CodeByAtharvSingh/Mavrik-Pocket/BOM.csv

Category | Item | Exact listing | Qty | Unit price (USD, as listed) | Line total (USD) | Line total with GST (USD) | Store | Link | Status | Notes
Electronics | Brain: ESP32-S3 N16R8 dev board | ESP32E-N16R8 Dual C-Type DOIT USB Development Board WiFi + Bluetooth Module | 1 | 7.27 | 7.27 | 8.58 | Quartz Components | https://quartzcomponents.com/products/esp32-s3-wroom-n16r8-dual-c-type-usb-development-board-wifi-bluetooth-module | Buy | 16 MB flash, 8 MB PSRAM. Check the chip cover says ESP32-S3-WROOM-1 N16R8
Electronics | Screen: 2.8 inch 240x320 SPI | 2.8 Inch SPI Touch Screen Display Module - TFT Display 240x320 | 1 | 7.97 | 7.97 | 9.41 | Quartz Components | https://quartzcomponents.com/products/2-8-inch-spi-touch-screen-module-tft-display-240-320 | Buy | ILI9341 driver; SD slot on the back holds the music and ideas
Electronics | Battery: 3.7 V 1200 mAh LiPo | 3.7V 1200mAH Li-Po Rechargeable Battery (KP 523450) | 1 | 2.50 | 2.50 | 2.94 | Quartz Components | https://quartzcomponents.com/products/3-7v-1200mah-li-po-rechargeable-battery | Buy | 5.2 x 34 x 50 mm. Check it is not puffed up when it arrives
Electronics | Charging + 5 V power | USB Type-C 5V Step-Up Booster Lithium Battery Charging and Protection Module | 1 | 0.29 | 0.29 | 0.34 | Quartz Components | https://quartzcomponents.com/products/usb-type-c-5v-step-up-booster-lithium-battery-charging-and-protection-module-for-power-bank | Buy | Charges the battery over USB-C and powers the board
Electronics | Microphone: INMP441 I2S | INMP441 MEMS Microphone Module I2S | 1 | 1.37 | 1.37 | 1.37 | Robo Bazar | https://robobazar.in/product/inmp441-mems-microphone-module-i2s/ | Buy | Sold out at Quartz: https://quartzcomponents.com/products/inmp441-mems-high-precision-omnidirectional-microphone-module-i2s
Electronics | Speaker amp: MAX98357A I2S | MAX98357 I2S Amplifier Audio | 1 | 0.90 | 0.90 | 0.90 | Robo Bazar | https://robobazar.in/product/max98357-i2s-amplifier-audio | Buy | Sold out at Quartz: https://quartzcomponents.com/products/max98357-3w-amplifier
Electronics | Speaker: 8 ohm 0.5 W | 0.5W 8 Ohm Speaker | 1 | 0.38 | 0.38 | 0.45 | Quartz Components | https://quartzcomponents.com/products/speaker-0-5w-8-ohm | Buy
Electronics | Scroll wheel: rotary encoder | HW-040 Rotary Encoder Module with Knob | 1 | 0.95 | 0.95 | 0.95 | Probots | https://probots.co.in/hw-040-rotary-encoder-module-with-knob-360-degree.html | Buy | Sold out at Quartz: https://quartzcomponents.com/products/rotary-encoder-module-ky-040. Trim the shaft to 5 mm above the thread for the printed knob
Electronics | Buttons: Action and Back | Tactile Momentary Push Button Switch 12x12x8mm 4-Pin | 2 | 0.04 | 0.09 | 0.10 | Quartz Components | https://quartzcomponents.com/products/tactile-momentary-push-button-switch-12-12-8mm-4-pin-black | Buy | Pressed by the printed side plungers
Electronics | Haptics: coin vibration motor | Micro Coin Vibration Motor (Page Motor) - 10mm Good Quality | 1 | 0.34 | 0.34 | 0.40 | Quartz Components | https://quartzcomponents.com/products/micro-coin-vibration-motor-page-motor-8mm | Buy | 10 x 3 mm, 3 V
Electronics | Motor driver transistor | BC547 NPN Transistor | 1 | 0.03 | 0.03 | 0.04 | Quartz Components | https://quartzcomponents.com/products/bc547-npn-amplifier-transistor | Buy
Electronics | Motor protection diode | 1N4007 General Purpose Rectifier Diode 1A | 1 | 0.02 | 0.02 | 0.02 | Quartz Components | https://quartzcomponents.com/products/1n4007-diode | Buy | Across the motor, stripe to +
Electronics | Transistor base resistor | 1K ohm 1/4 Watt Resistor 5% (Pack of 10) | 1 | 0.07 | 0.07 | 0.09 | Quartz Components | https://quartzcomponents.com/products/1k-ohm-1-4-watt-resistor | Buy | Smallest pack sold
Electronics | Storage: microSD card | SanDisk Ultra Micro SD 32GB Class 10 | 1 | 0.00 | 0.00 | 0.00 | Quartz Components | https://quartzcomponents.com/products/32gb-ultra-microsd-memory-card-red-grey | Already own | Use a card you already have (any 4-32 GB works). Quartz price if you need one: $15.93
Assembly | Perfboard for the final wiring | 50 x 70 mm Double Side Prototype PCB | 1 | 0.34 | 0.34 | 0.40 | Quartz Components | https://quartzcomponents.com/products/wifi-esp8266-double-side-prototype-pcb-breadboard-50x70mm | Buy | Holds the motor driver and button wiring. No custom PCB in this prototype
Assembly | Header pins | 40 Pin Straight Male Header Pins - Berg Strips | 1 | 0.07 | 0.07 | 0.09 | Quartz Components | https://quartzcomponents.com/products/40-pin-break-away-headers-straight-male-headers | Buy
Assembly | Jumper wires | Female to Female Jumper Wires 10cm (Set of 40) | 1 | 0.40 | 0.40 | 0.48 | Quartz Components | https://quartzcomponents.com/products/female-to-female-connecting-wires-jumper-wires-10cm-set-of-40 | Buy | Short wires fit inside the case
Assembly | Breadboard for first tests | MB102 Breadboard 830 Points with Jumper Wires (Set of 80) | 1 | 1.96 | 1.96 | 2.31 | Quartz Components | https://quartzcomponents.com/products/mb102-colored-breadboard-830-points-with-jumper-wires-male-to-male-and-male-to-female-set-of-80 | Buy | Test everything here before soldering
Enclosure | Front shell, back cover, wheel knob, 2 button plungers | SLA resin print (black resin) from STEP Files/Prototype case | 1 | 21.26 | 21.26 | 21.26 | JLC3DP | https://jlc3dp.com/ | Buy | Resin gives the smooth, sharp-edged finish closest to an iPhone. About 60 cm3 of resin. Estimate incl. shipping to India: upload the STEP files for the exact price. Indian option: Zbotic SLA (15-20 days) https://zbotic.in/3d-printing-service/sla/
Tools | Soldering iron | Soldering Iron/Rod (25W) Noel | 1 | 1.21 | 1.21 | 1.44 | Quartz Components | https://quartzcomponents.com/products/soldering-iron-25w | Buy | A 25 W iron is enough for every joint here
Tools | Solder wire | Small Package Solder Wire 5 g | 2 | 0.24 | 0.49 | 0.57 | Quartz Components | https://quartzcomponents.com/products/akt-solder-wire-5gm | Buy | About 100 joints
Tools | Flux | Soldering and Desoldering Flux Paste 10 g | 1 | 0.23 | 0.23 | 0.28 | Quartz Components | https://quartzcomponents.com/collections/soldering-accessories/products/soldering-and-desoldering-flux-paste-white | Buy
Total | Everything to buy |  |  |  |  | 52.42 |  |  |  | Quartz prices + 18% GST; Robo Bazar and Probots prices already include GST; the enclosure print is an estimate. Shipping on the small orders not included. Converted at 1 USD = 94.07 INR (12 Nov 2026)
