CodeByAtharvSingh/Mavrik-Pocket/STEP Files/Concept 8mm/00_full_assembly.step

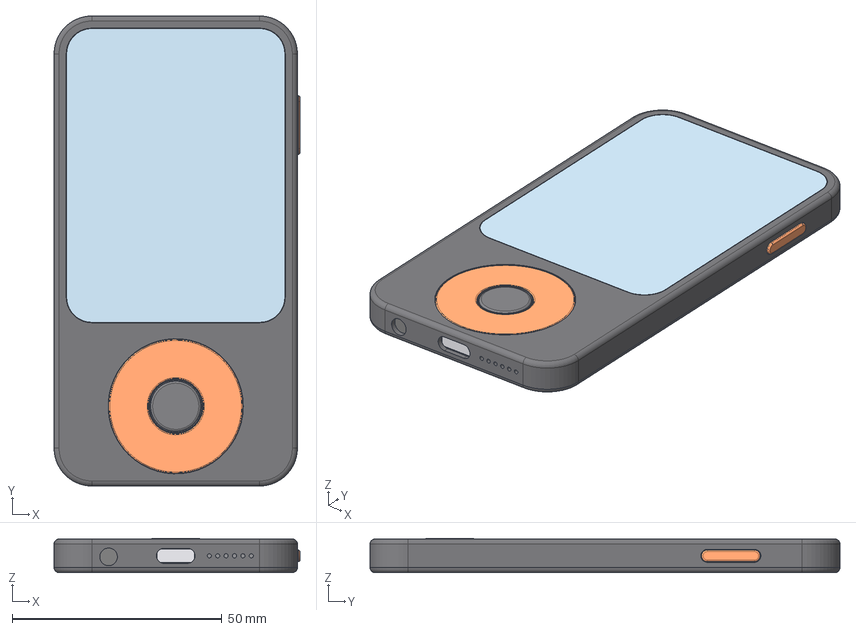
[picture p9: CAD file, 2026-11-12]
STEP Files/Concept 8mm/00_full_assembly.step
58.6 x 112.0 x 8.15 mm
front_shell
back_cover
cover_glass
touch_wheel_ring
centre_button
action_button
magnet_ring
lanyard_pin
ref_display_panel
ref_battery_3x40x50
ref_main_pcb
ref_select_dome
ref_touch_wheel_flex
ref_usb_c_socket
ref_headphone_jack
ref_speaker_box
ref_mic
ref_haptic_motor
