CodeByAtharvSingh/Mavrik-Pocket/STEP Files/Concept 8mm/ref_main_pcb.step

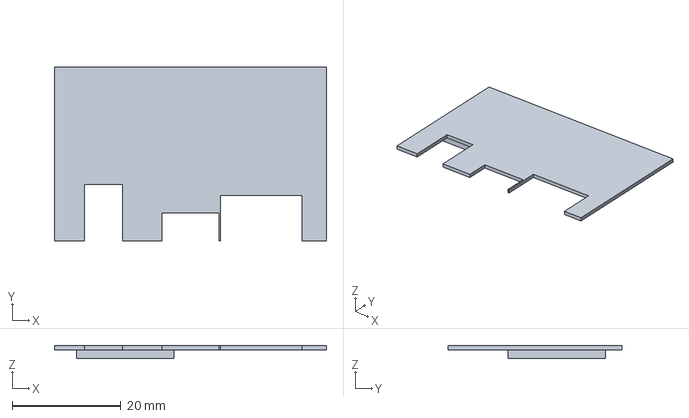
[picture p10: CAD file, 2026-11-12]
STEP Files/Concept 8mm/ref_main_pcb.step
50.0 x 32.0 x 2.40 mm
