CodeByAtharvSingh/Mavrik-Pocket/STEP Files/Prototype case/00_full_assembly.step

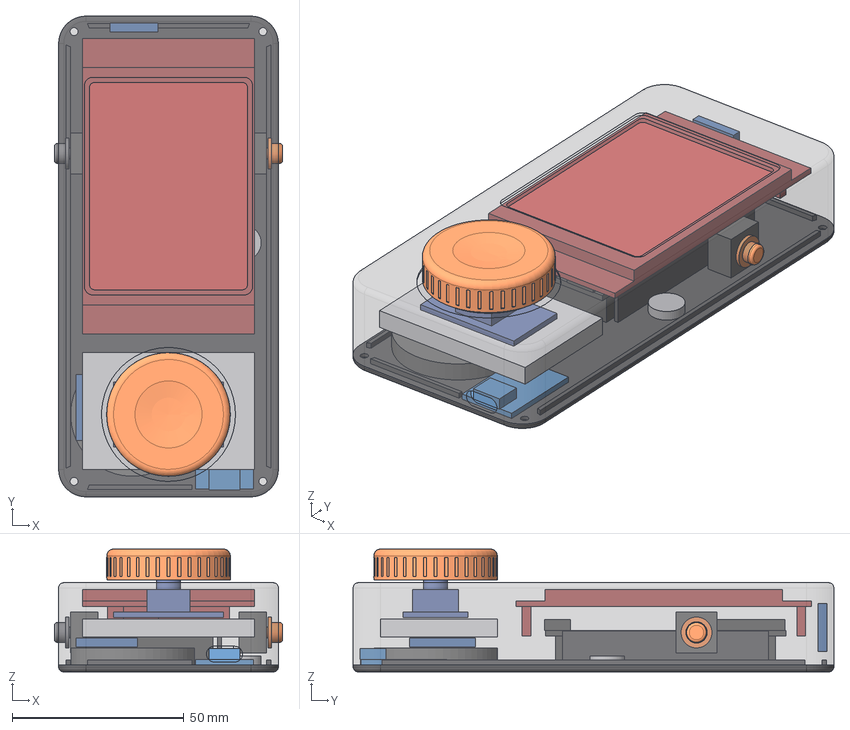
[picture p11: CAD file, 2026-11-12]
STEP Files/Prototype case/00_full_assembly.step
66.4 x 140.0 x 35.8 mm
front_shell
back_cover
wheel_knob
action_plunger
back_plunger
ref_screen_module
ref_esp32_s3_devboard
ref_battery_523450
ref_encoder_ky040
ref_speaker
ref_charger_module
ref_tactile_switches
ref_mic_inmp441
ref_amp_max98357
ref_vibration_motor
