CodeByAtharvSingh/Mavrik-Pocket/STEP Files/Concept 8mm/lanyard_pin.step

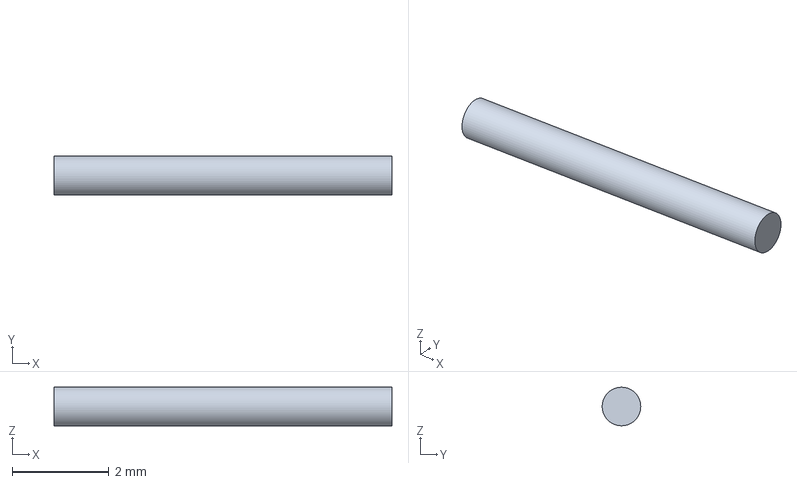
[picture p12: CAD file, 2026-11-12]
STEP Files/Concept 8mm/lanyard_pin.step
7.00 x 0.799 x 0.8 mm
