CodeByAtharvSingh/Mavrik-Pocket/STEP Files/Prototype case/ref_battery_523450.step

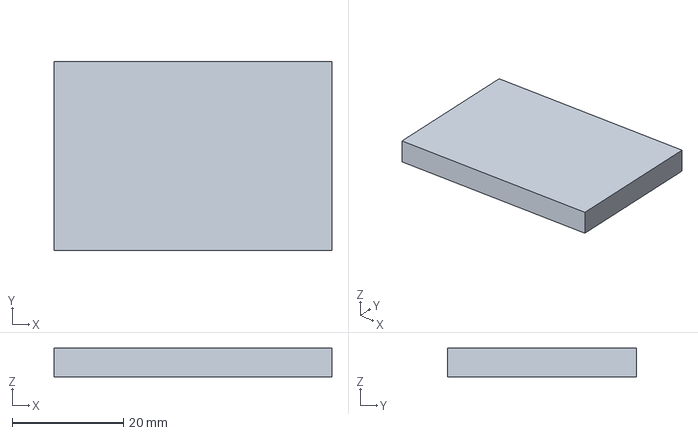
[picture p13: CAD file, 2026-11-12]
STEP Files/Prototype case/ref_battery_523450.step
50.0 x 34.0 x 5.20 mm
