CodeByAtharvSingh/Mavrik-Pocket/STEP Files/Concept 8mm/ref_mic.step

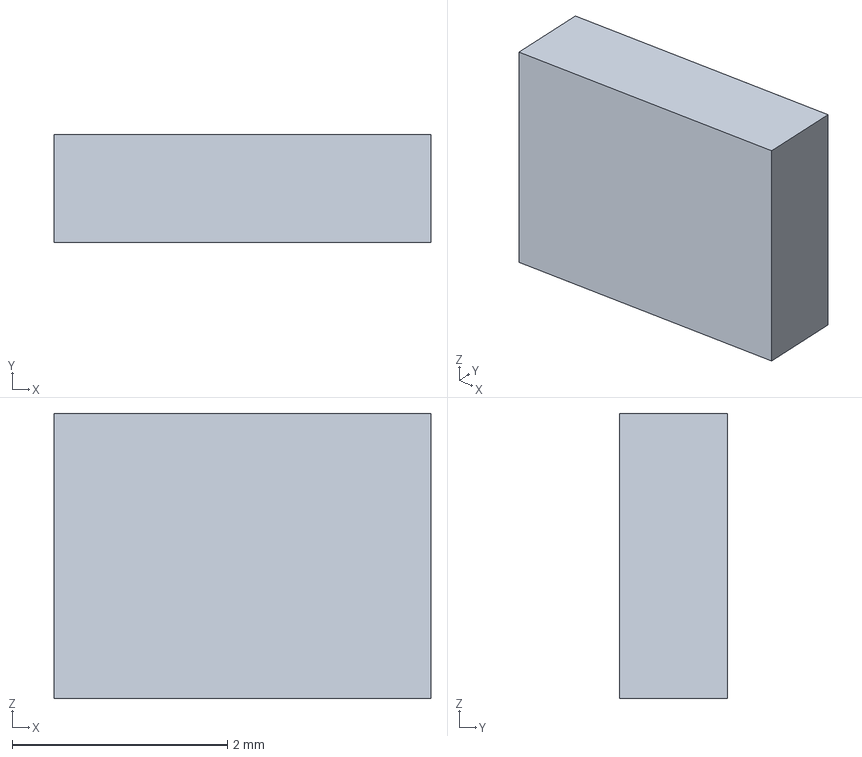
[picture p14: CAD file, 2026-11-12]
STEP Files/Concept 8mm/ref_mic.step
3.50 x 1.00 x 2.65 mm
