CodeByAtharvSingh/Mavrik-Pocket/STEP Files/Prototype case/ref_esp32_s3_devboard.step

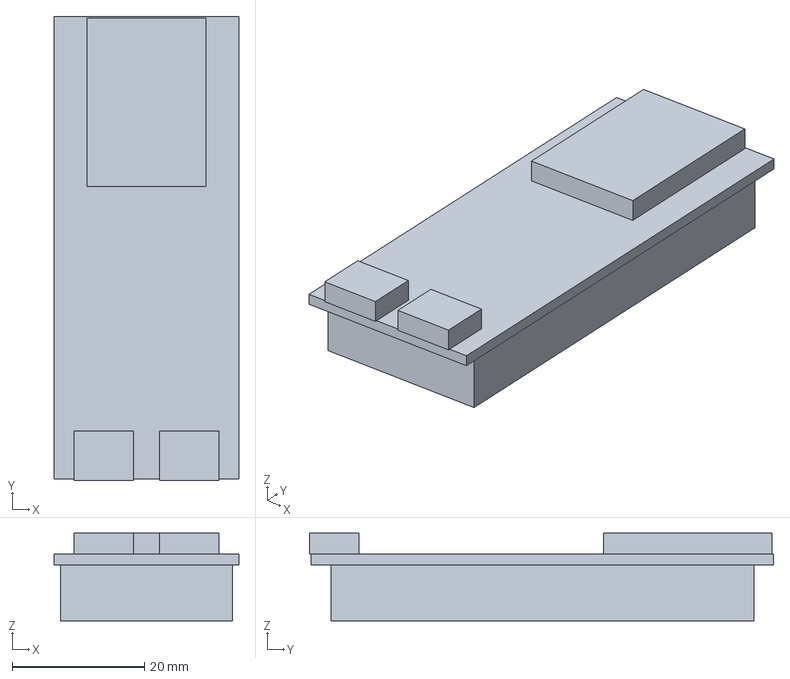
[picture p15: CAD file, 2026-11-12]
STEP Files/Prototype case/ref_esp32_s3_devboard.step
28.0 x 70.2 x 13.3 mm
