CodeByAtharvSingh/Mavrik-Pocket/STEP Files/Prototype case/back_cover.step

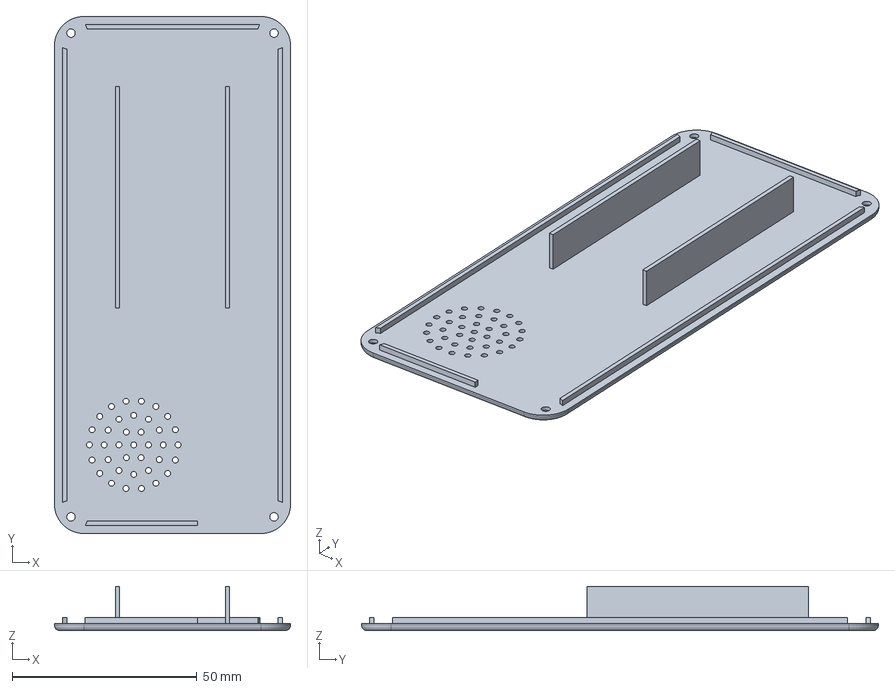
[picture p16: CAD file, 2026-11-12]
STEP Files/Prototype case/back_cover.step
64.0 x 140.0 x 12.0 mm
