CodeByAtharvSingh/Mavrik-Pocket/STEP Files/Concept 8mm/front_shell.step

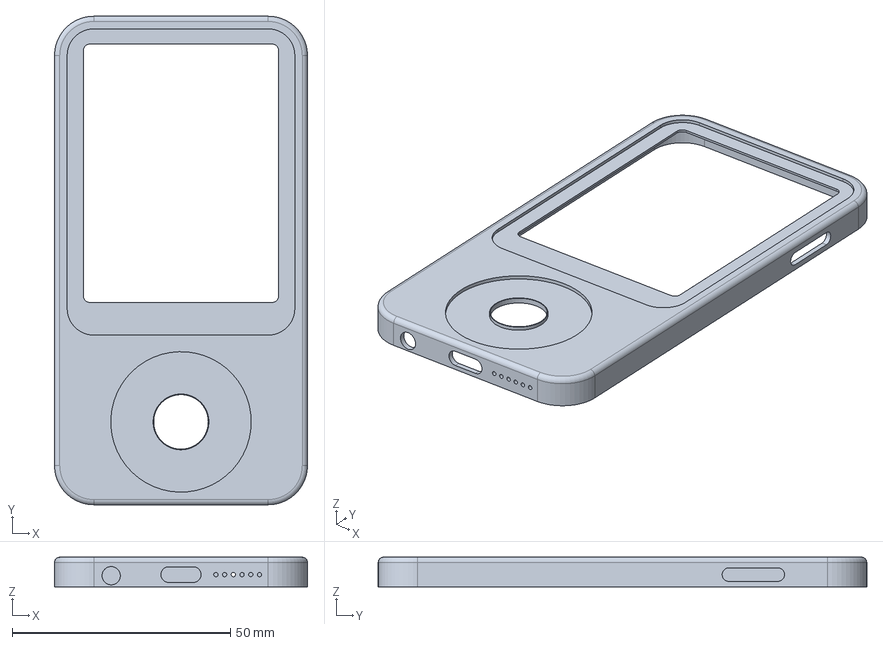
[picture p17: CAD file, 2026-11-12]
STEP Files/Concept 8mm/front_shell.step
58.0 x 112.0 x 6.80 mm
