CodeByAtharvSingh/Mavrik-Pocket/STEP Files/Prototype case/ref_vibration_motor.step

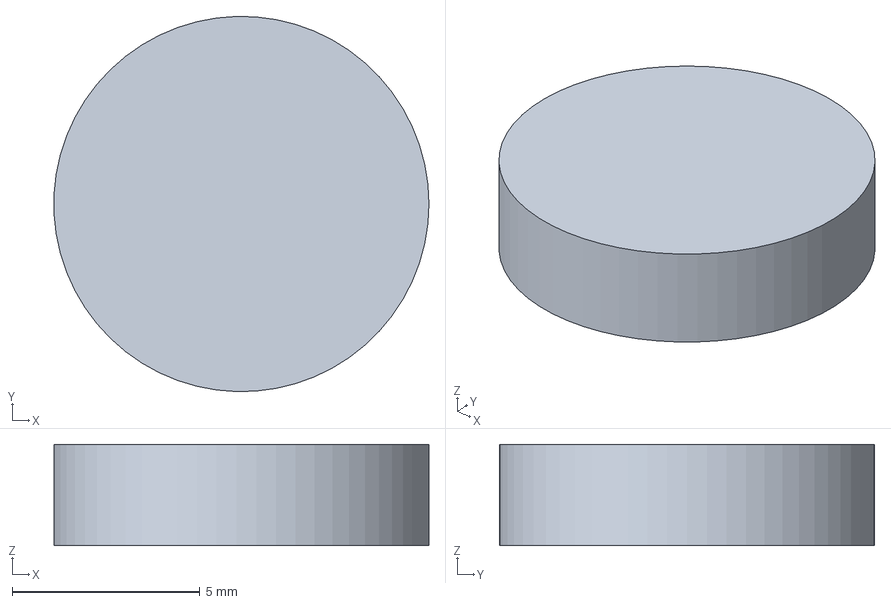
[picture p18: CAD file, 2026-11-12]
STEP Files/Prototype case/ref_vibration_motor.step
9.99 x 10.00 x 2.70 mm
