CodeByAtharvSingh/Mavrik-Pocket/STEP Files/Prototype case/ref_speaker.step

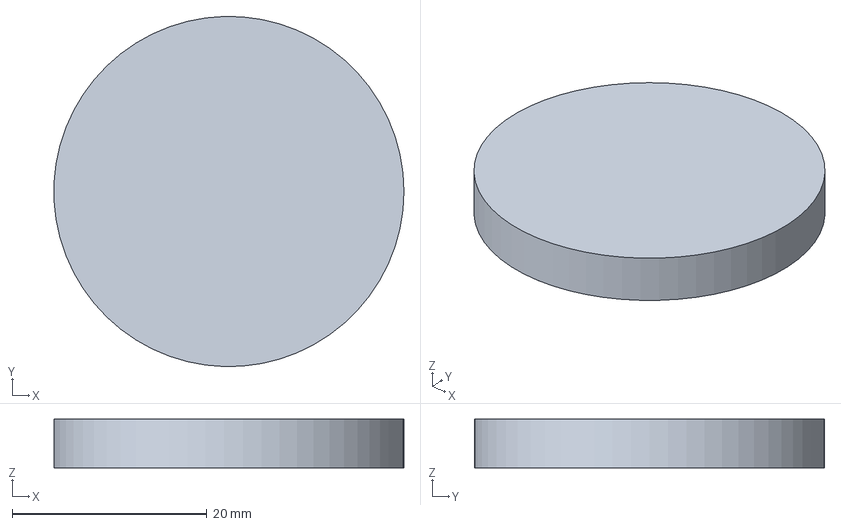
[picture p19: CAD file, 2026-11-12]
STEP Files/Prototype case/ref_speaker.step
36.0 x 36.0 x 5.00 mm
