CodeByAtharvSingh/Mavrik-Pocket/STEP Files/Concept 8mm/ref_haptic_motor.step

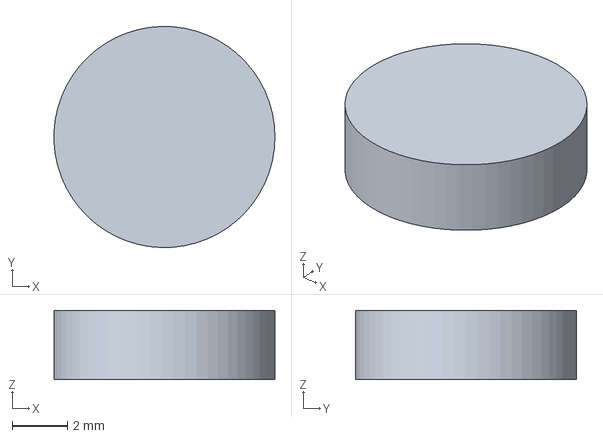
[picture p20: CAD file, 2026-11-12]
STEP Files/Concept 8mm/ref_haptic_motor.step
7.99 x 8.00 x 2.50 mm
