CodeByAtharvSingh/Mavrik-Pocket/STEP Files/Prototype case/ref_tactile_switches.step

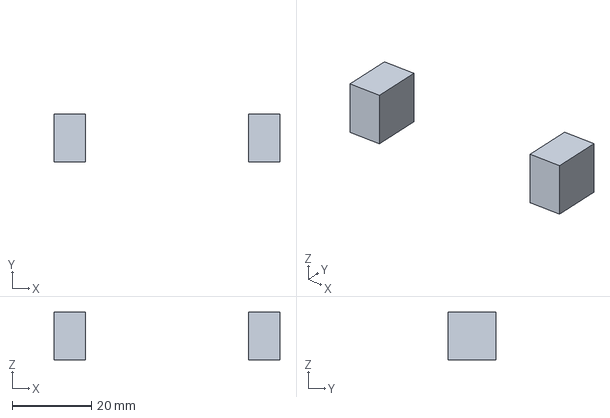
[picture p21: CAD file, 2026-11-12]
STEP Files/Prototype case/ref_tactile_switches.step
57.0 x 12.0 x 12.0 mm
