CodeByAtharvSingh/Mavrik-Pocket/STEP Files/Concept 8mm/ref_speaker_box.step

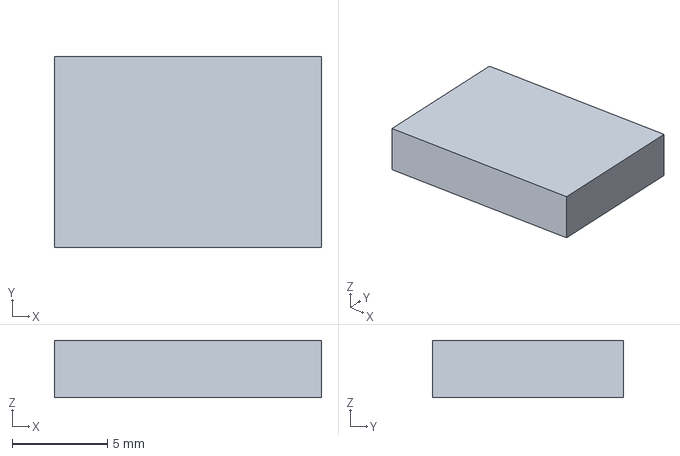
[picture p22: CAD file, 2026-11-12]
STEP Files/Concept 8mm/ref_speaker_box.step
14.0 x 10.0 x 3.00 mm
