CodeByAtharvSingh/Mavrik-Pocket/STEP Files/Prototype case/ref_encoder_ky040.step

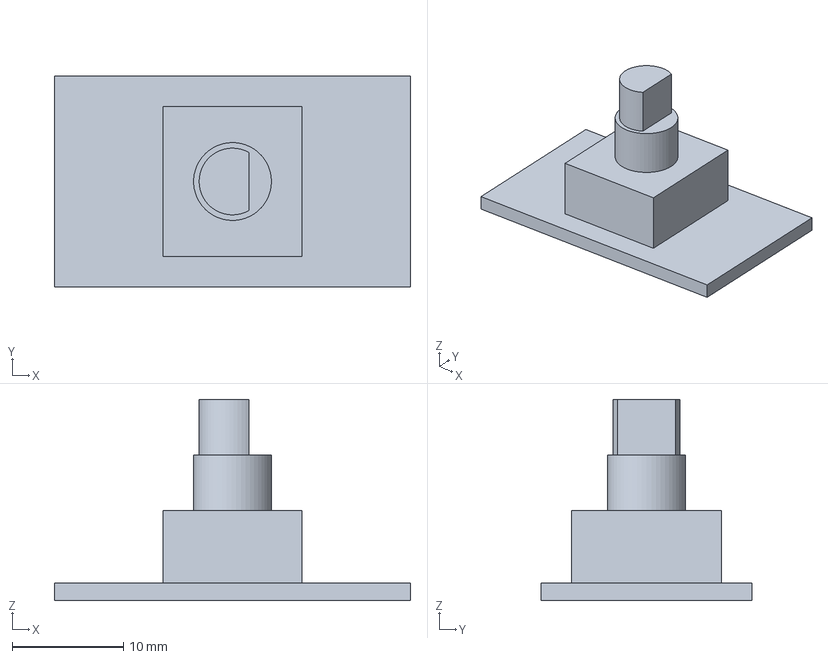
[picture p23: CAD file, 2026-11-12]
STEP Files/Prototype case/ref_encoder_ky040.step
32.0 x 19.0 x 18.1 mm
