CodeByAtharvSingh/Mavrik-Pocket/STEP Files/Concept 8mm/ref_headphone_jack.step

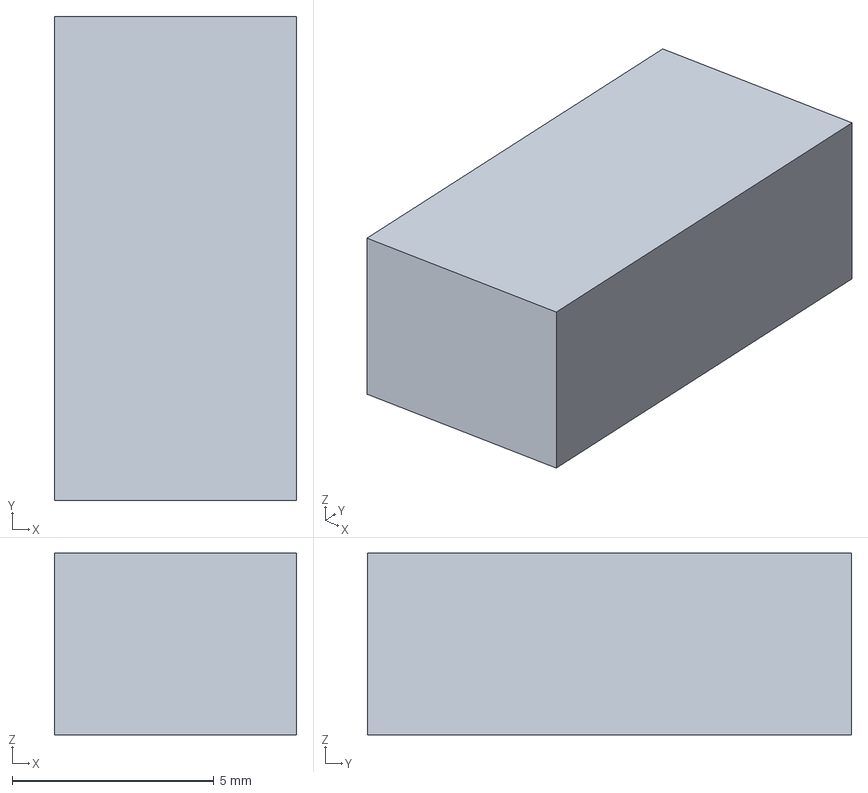
[picture p24: CAD file, 2026-11-12]
STEP Files/Concept 8mm/ref_headphone_jack.step
6.00 x 12.0 x 4.50 mm
