CodeByAtharvSingh/Mavrik-Pocket/STEP Files/Prototype case/ref_mic_inmp441.step

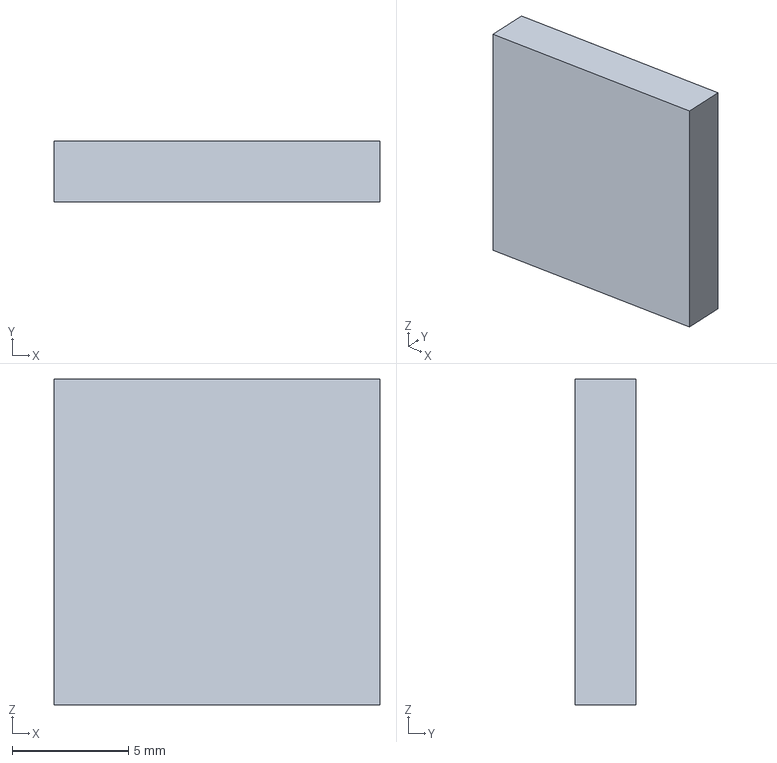
[picture p25: CAD file, 2026-11-12]
STEP Files/Prototype case/ref_mic_inmp441.step
14.0 x 2.60 x 14.0 mm
