CodeByAtharvSingh/Mavrik-Pocket/STEP Files/Concept 8mm/touch_wheel_ring.step

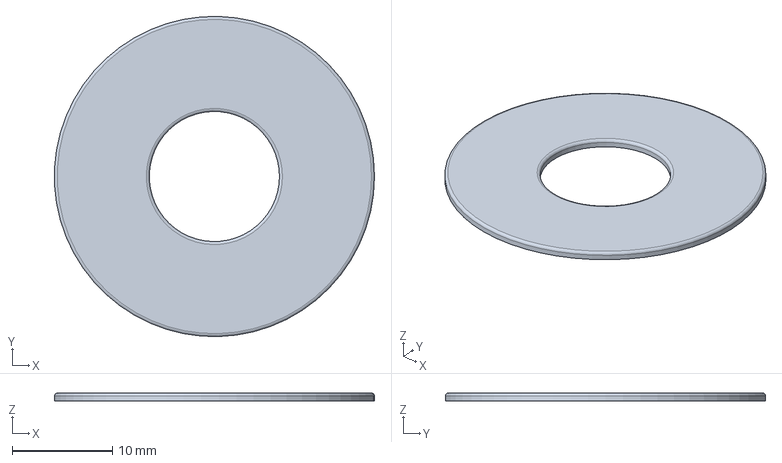
[picture p26: CAD file, 2026-11-12]
STEP Files/Concept 8mm/touch_wheel_ring.step
32.0 x 32.0 x 0.8 mm
