CodeByAtharvSingh/Mavrik-Pocket/STEP Files/Prototype case/ref_charger_module.step

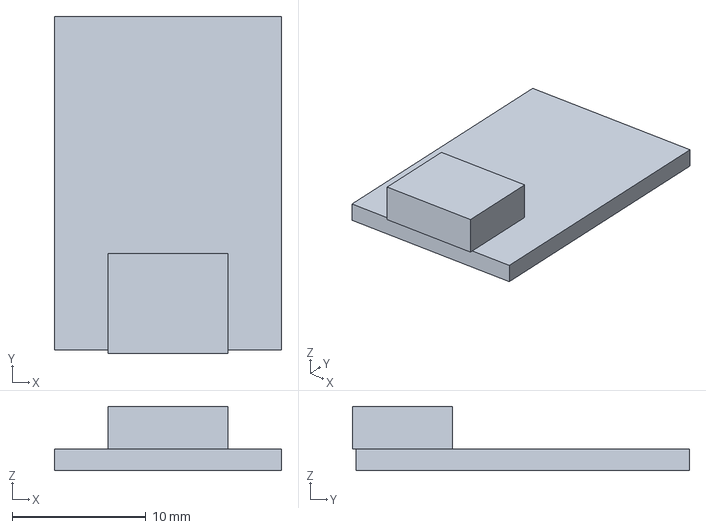
[picture p27: CAD file, 2026-11-12]
STEP Files/Prototype case/ref_charger_module.step
17.0 x 25.2 x 4.80 mm
