CodeByAtharvSingh/Mavrik-Pocket/STEP Files/Concept 8mm/magnet_ring.step

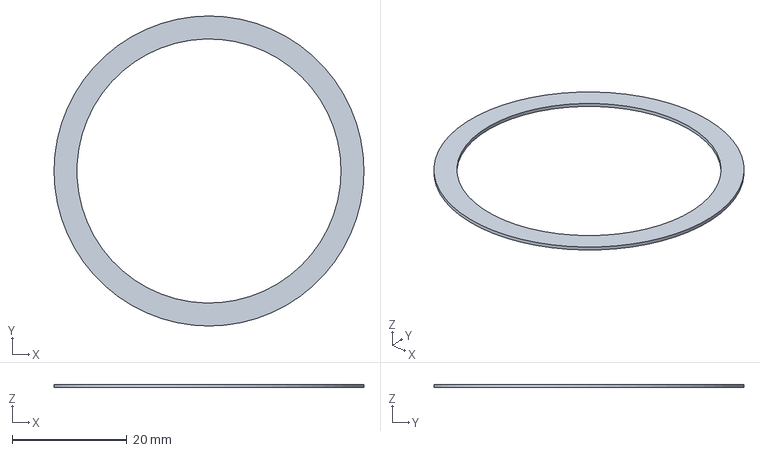
[picture p28: CAD file, 2026-11-12]
STEP Files/Concept 8mm/magnet_ring.step
54.0 x 54.0 x 0.6 mm
