CodeByAtharvSingh/Mavrik-Pocket/STEP Files/Prototype case/button_plunger.step

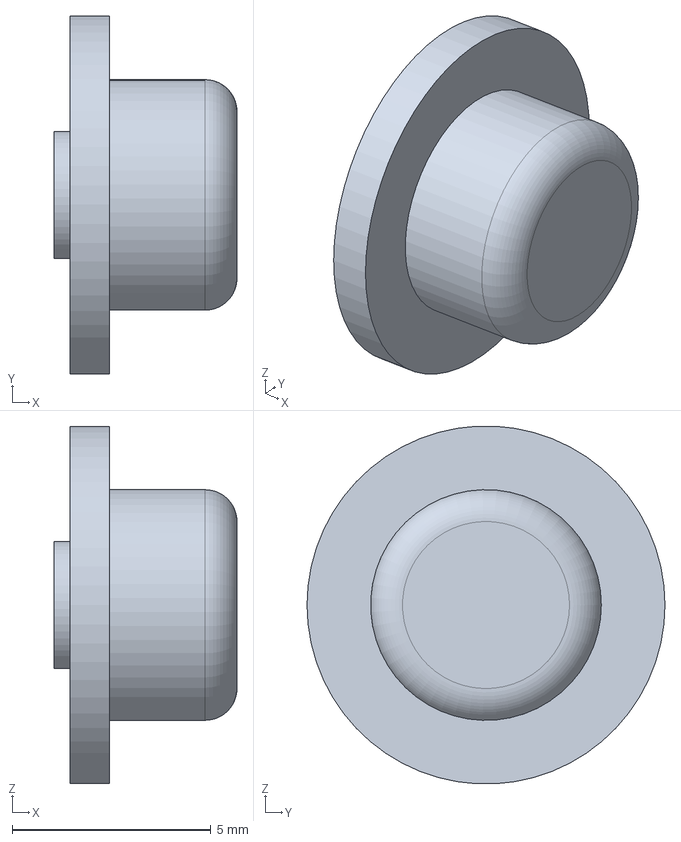
[picture p29: CAD file, 2026-11-12]
STEP Files/Prototype case/button_plunger.step
4.60 x 9.00 x 8.99 mm
