CodeByAtharvSingh/Mavrik-Pocket/STEP Files/Concept 8mm/ref_usb_c_socket.step

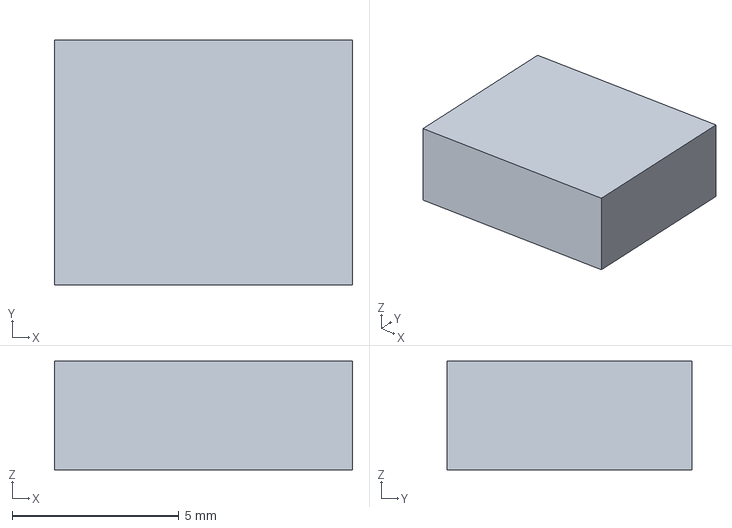
[picture p30: CAD file, 2026-11-12]
STEP Files/Concept 8mm/ref_usb_c_socket.step
8.94 x 7.35 x 3.26 mm
