CodeByAtharvSingh/Mavrik-Pocket/STEP Files/Prototype case/ref_amp_max98357.step

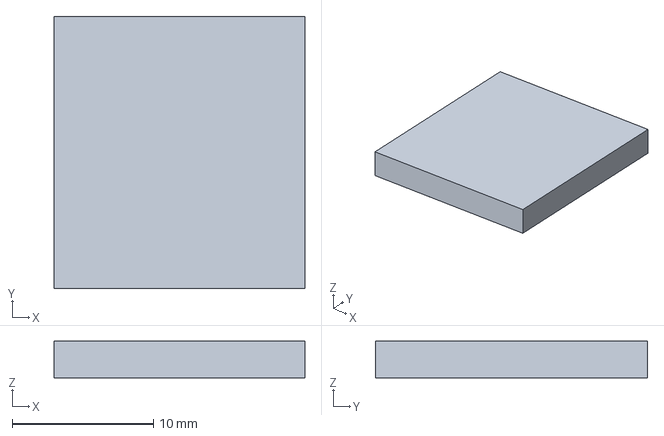
[picture p31: CAD file, 2026-11-12]
STEP Files/Prototype case/ref_amp_max98357.step
17.8 x 19.3 x 2.60 mm
