CodeByAtharvSingh/Mavrik-Pocket/STEP Files/Concept 8mm/cover_glass.step

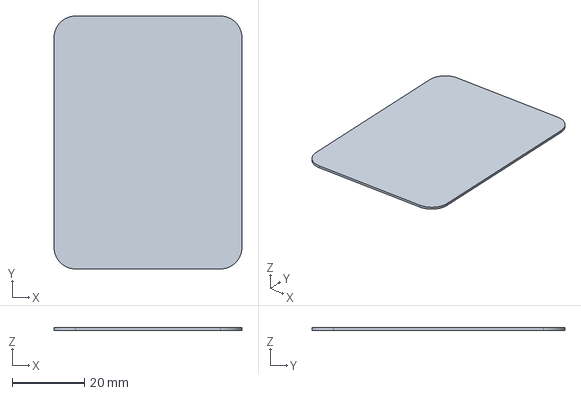
[picture p32: CAD file, 2026-11-12]
STEP Files/Concept 8mm/cover_glass.step
52.0 x 70.0 x 0.7 mm
