CodeByAtharvSingh/Mavrik-Pocket/STEP Files/Prototype case/ref_screen_module.step

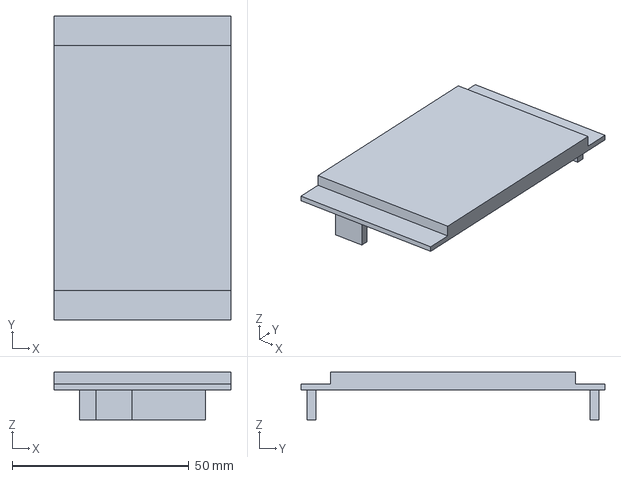
[picture p33: CAD file, 2026-11-12]
STEP Files/Prototype case/ref_screen_module.step
50.0 x 86.0 x 13.5 mm
