CodeByAtharvSingh/Mavrik-Pocket/STEP Files/Concept 8mm/centre_button.step

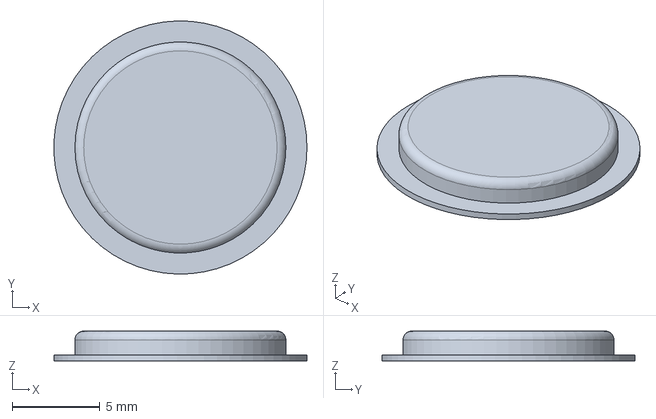
[picture p34: CAD file, 2026-11-12]
STEP Files/Concept 8mm/centre_button.step
14.4 x 14.4 x 1.70 mm
