CodeByAtharvSingh/Mavrik-Pocket/STEP Files/Concept 8mm/action_button.step

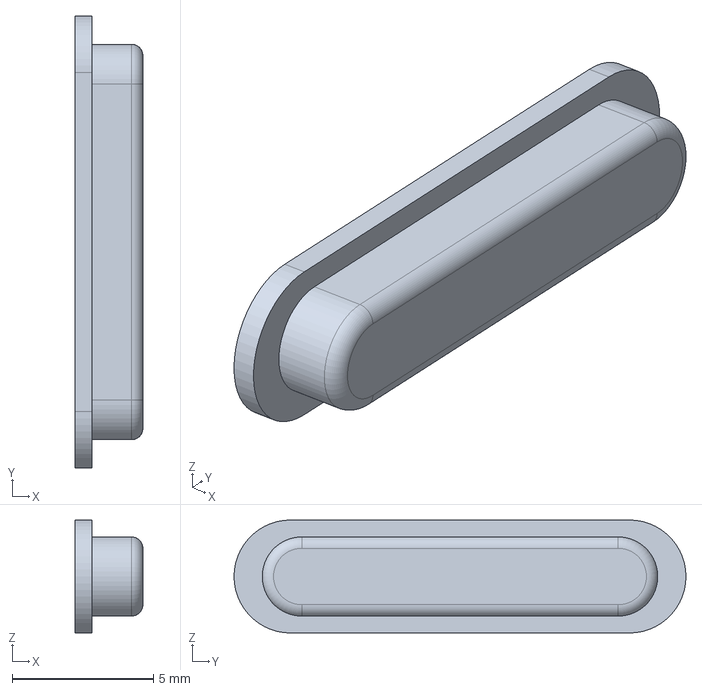
[picture p35: CAD file, 2026-11-12]
STEP Files/Concept 8mm/action_button.step
2.40 x 16.0 x 4.00 mm
