CodeByAtharvSingh/Mavrik-Pocket/STEP Files/Prototype case/front_shell.step

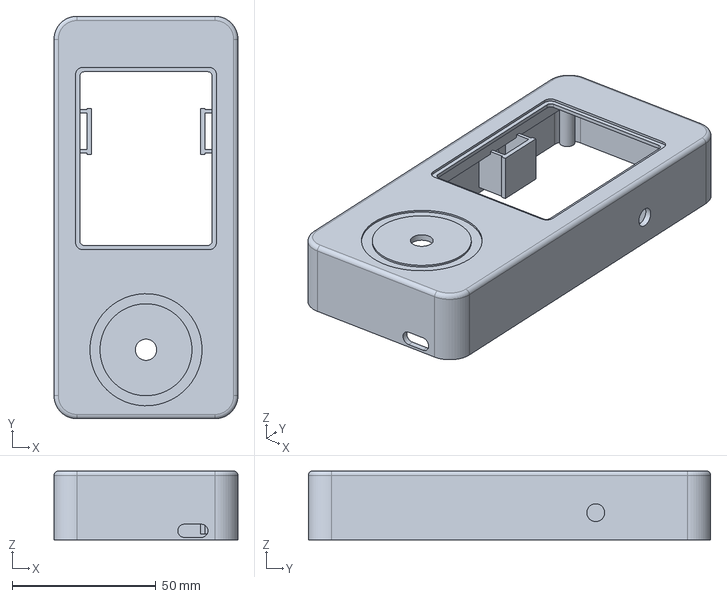
[picture p36: CAD file, 2026-11-12]
STEP Files/Prototype case/front_shell.step
64.0 x 140.0 x 24.0 mm
