CodeByAtharvSingh/Mavrik-Pocket/STEP Files/Concept 8mm/ref_battery_3x40x50.step

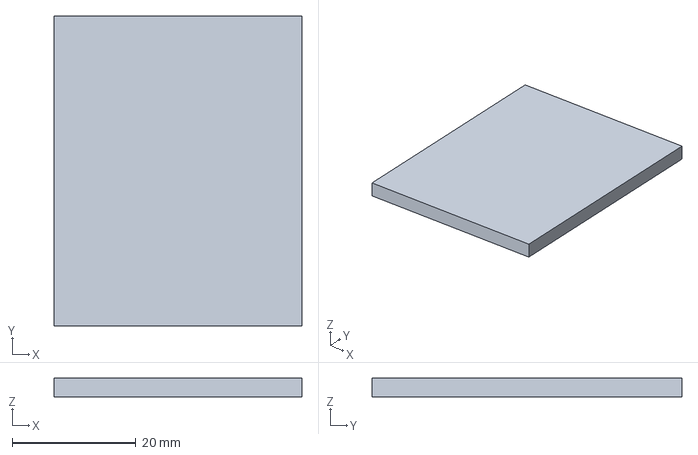
[picture p37: CAD file, 2026-11-12]
STEP Files/Concept 8mm/ref_battery_3x40x50.step
40.0 x 50.0 x 3.00 mm
