CodeByAtharvSingh/Mavrik-Pocket/STEP Files/Prototype case/wheel_knob.step

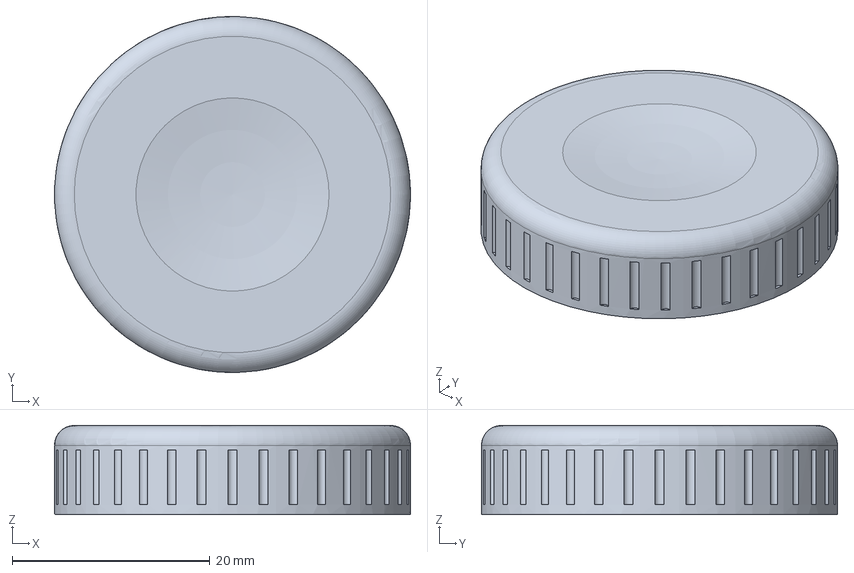
[picture p38: CAD file, 2026-11-12]
STEP Files/Prototype case/wheel_knob.step
36.0 x 36.0 x 9.00 mm
