CodeByAtharvSingh/Mavrik-Pocket/STEP Files/Concept 8mm/ref_select_dome.step

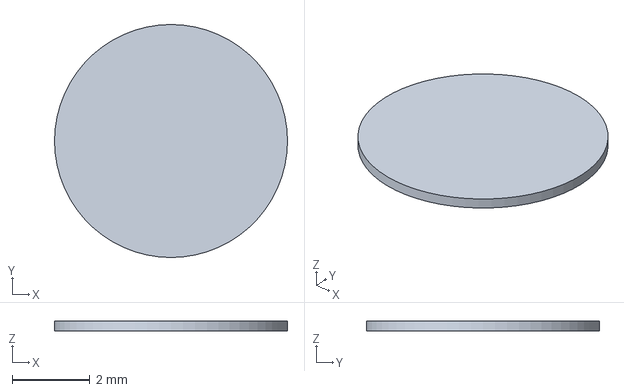
[picture p39: CAD file, 2026-11-12]
STEP Files/Concept 8mm/ref_select_dome.step
6.00 x 6.00 x 0.25 mm
