CodeByAtharvSingh/Mavrik-Pocket/STEP Files/Concept 8mm/ref_touch_wheel_flex.step

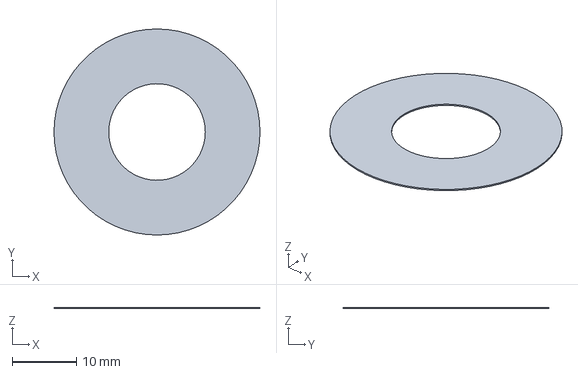
[picture p40: CAD file, 2026-11-12]
STEP Files/Concept 8mm/ref_touch_wheel_flex.step
32.0 x 32.0 x 0.2 mm
