CodeByAtharvSingh/Mavrik-Pocket/STEP Files/Concept 8mm/Mavrik_Pocket_Concept_8mm.FCStd

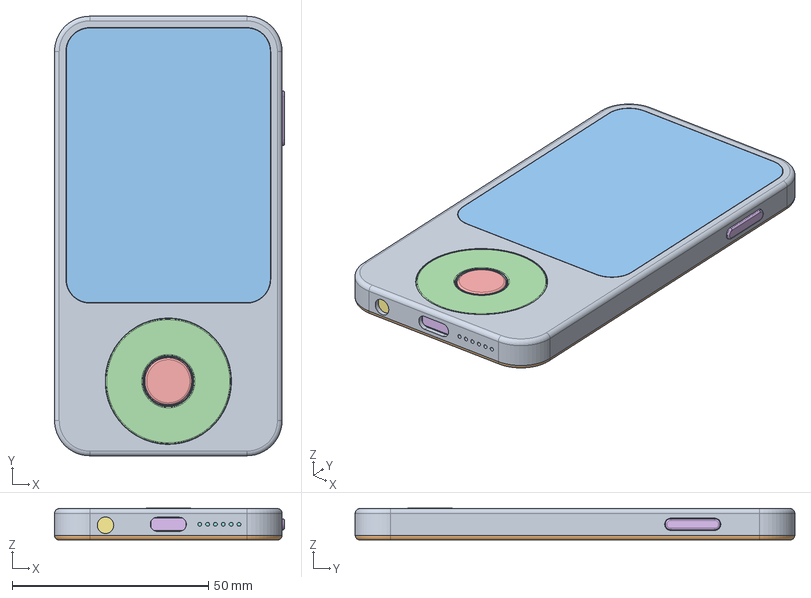
[picture p41: CAD file, 2026-11-12]
STEP Files/Concept 8mm/Mavrik_Pocket_Concept_8mm.FCStd
58.6 x 112.0 x 8.15 mm
Front shell x 2
Back cover x 2
Cover glass x 2
Touch wheel ring x 2
Centre button x 2
Action button x 2
Magnet ring x 2
Lanyard pin x 2
2.8in display panel x 2
Battery 3x40x50 x 2
Main board x 2
Select dome switch x 2
Touch wheel flex x 2
USB-C socket x 2
Headphone jack x 2
Speaker box x 2
Microphone x 2
Haptic motor x 2
