CodeByAtharvSingh/Mavrik-Pocket/STEP Files/Concept 8mm/back_cover.step

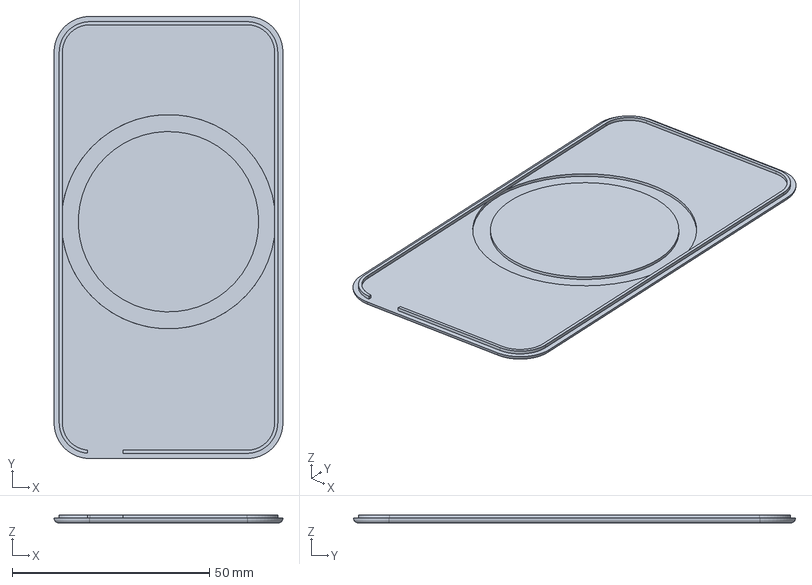
[picture p42: CAD file, 2026-11-12]
STEP Files/Concept 8mm/back_cover.step
58.0 x 112.0 x 2.00 mm
