CodeByAtharvSingh/Mavrik-Pocket/STEP Files/Concept 8mm/ref_display_panel.step

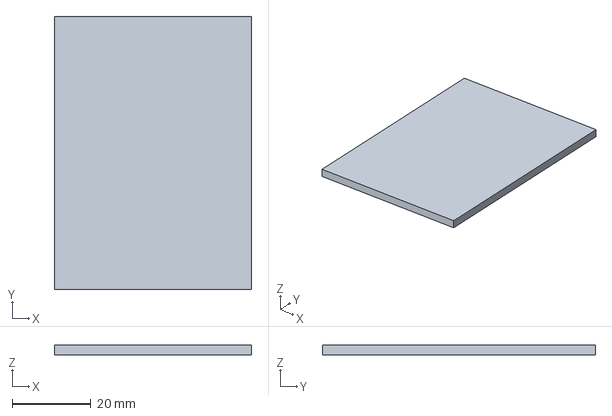
[picture p43: CAD file, 2026-11-12]
STEP Files/Concept 8mm/ref_display_panel.step
50.0 x 69.2 x 2.45 mm
