CodeByAtharvSingh/Mavrik-Pocket/(list of files, cad)

Other CAD files:
STEP Files/Prototype case/Mavrik_Pocket_Prototype_Case.FCStd
