CodeByAtharvSingh/Mavrik-Pocket/(commit log)

2026-11-12 First upload
    [00_full_assembly.step, BOM.csv, Mavrik_Pocket_Concept_8mm.FCStd, Mavrik_Pocket_Prototype_Case.FCStd, action_button.step, back_cover.step, button_plunger.step, centre_button.step]
2026-11-12 BOM: remove items without links, prices in USD
    [BOM.csv]
